gyuha/vertical-laptop-stand/.forge/followups.md

# Follow-ups

<!-- followup: fu-c87028a1e309 | source: printable-snap-retainer | task: 3 | date: 2026-10-28 | status: open | taken: - -->
- 소형 시험판을 X1C PLA로 출력한 뒤 새 클립의 삽입·분리, 갈라짐/흰 변형 자국, 축 방향 고정과 두 끝 회전 걸림을 확인하고 필요하면 여유·입구를 조정합니다.
  근거: 이번 계획은 실제 출력과 탄성·유지력 합격을 제외했으며, 실행 기록과 `docs/snap-retainer.md`의 실물 확인 양식은 미시험 상태입니다. 디지털 검사 통과와 구분한 후속 후보이고 자동 실행하지 않습니다.

<!-- followup: fu-9b2aa15bb850 | source: print-in-place-hinge | task: 4 | date: 2026-10-28 | status: open | taken: - -->
경첩 시험편(hinge-trial)을 X1C PLA·서포트 없이 출력해 출력 직후 풀림, 위 마디 원뿔 첫 링(302° 비지지)의 처짐·붙음, 흔들림을 확인하고 필요하면 radial_clearance·cone_normal_gap을 조정한다.
