gyuha/vertical-laptop-stand/docs/evidence/front-loaded.png

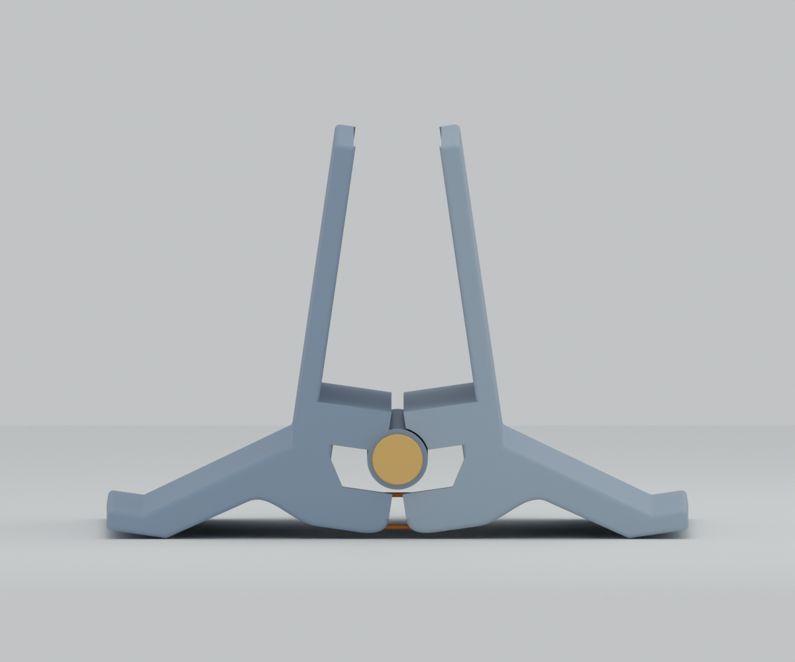
docs/evidence/front-loaded.png
