gyuha/vertical-laptop-stand/docs/evidence/front-open.png

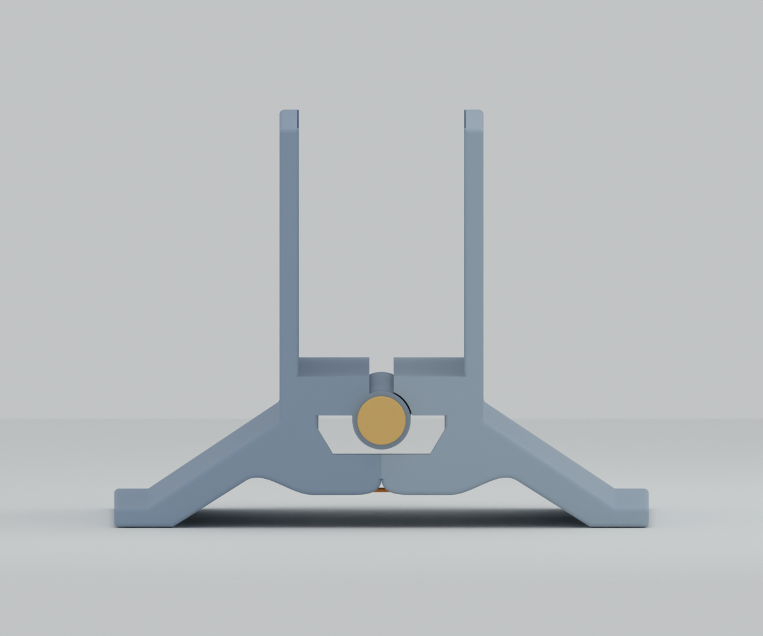
docs/evidence/front-open.png
