gyuha/vertical-laptop-stand/docs/evidence/hook-detail.png

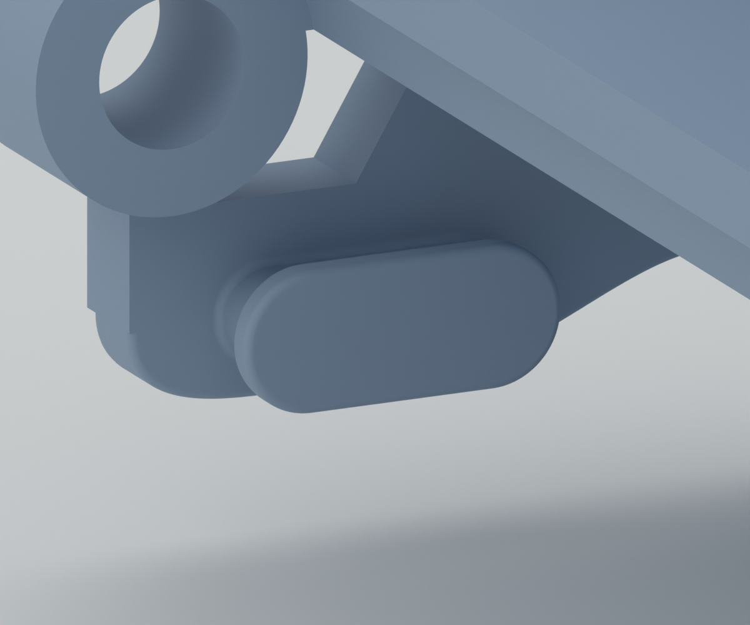
docs/evidence/hook-detail.png
