gyuha/vertical-laptop-stand/docs/evidence/hooks-preview.png

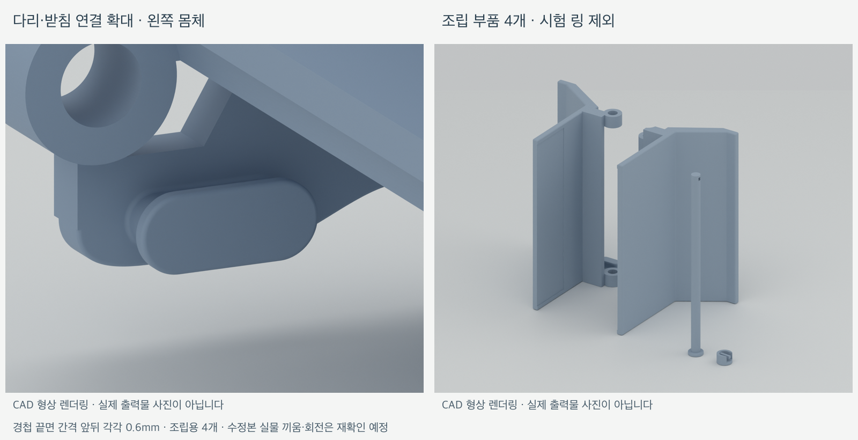
docs/evidence/hooks-preview.png
