gyuha/vertical-laptop-stand/docs/evidence/inside-loaded.png

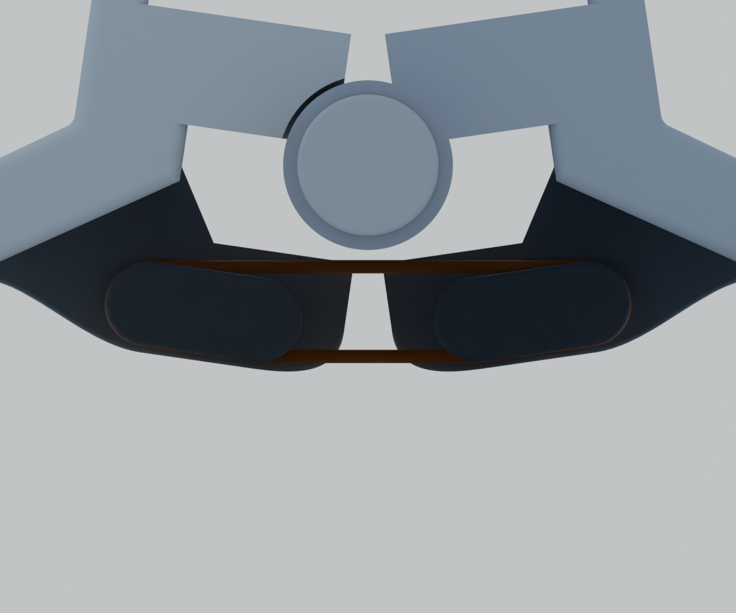
docs/evidence/inside-loaded.png
