gyuha/vertical-laptop-stand/docs/evidence/inside-open.png

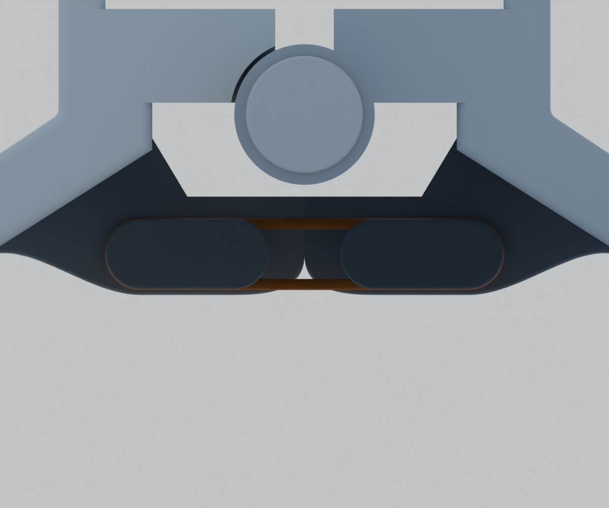
docs/evidence/inside-open.png
