gyuha/vertical-laptop-stand/docs/evidence/joint-detail-loaded.png

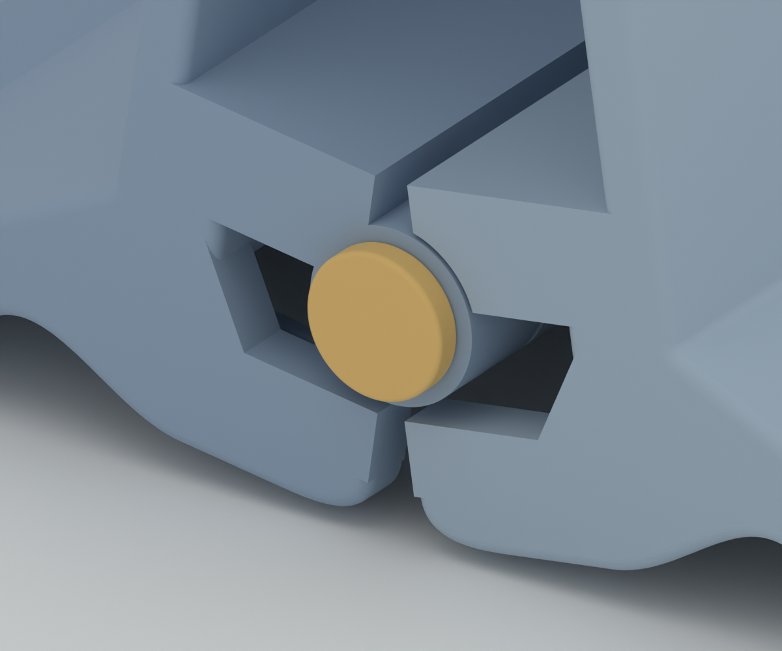
docs/evidence/joint-detail-loaded.png
