gyuha/vertical-laptop-stand/docs/evidence/joint-detail-open.png

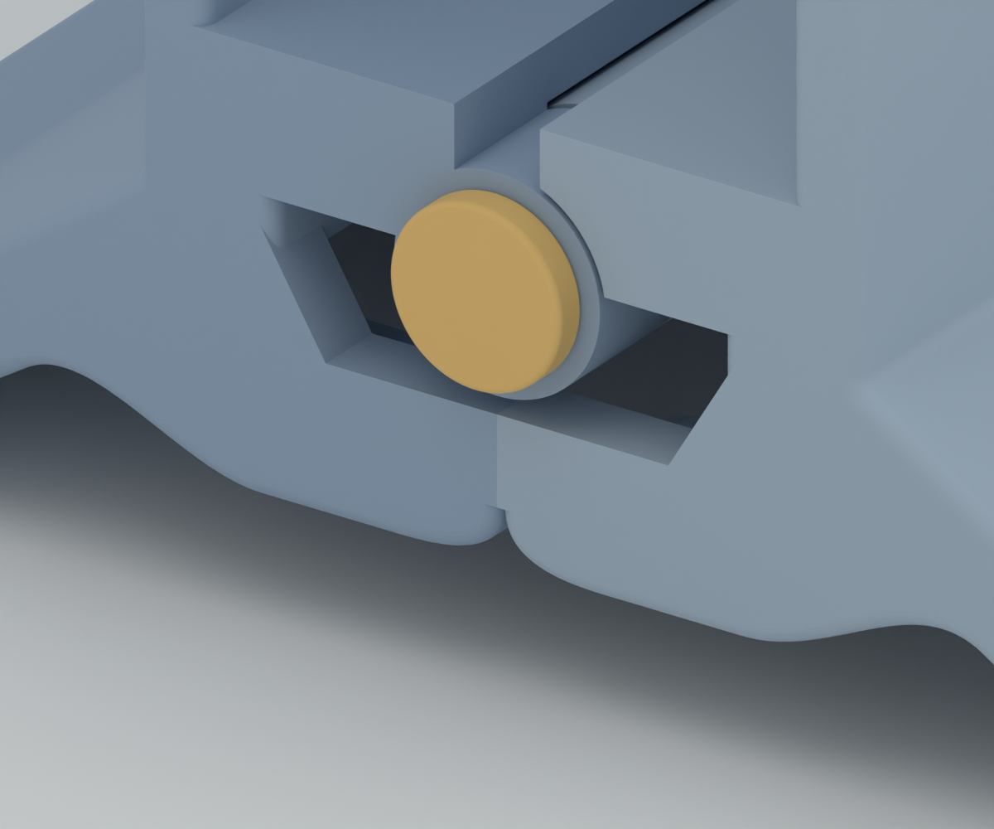
docs/evidence/joint-detail-open.png
