gyuha/vertical-laptop-stand/docs/evidence/key-detail.png

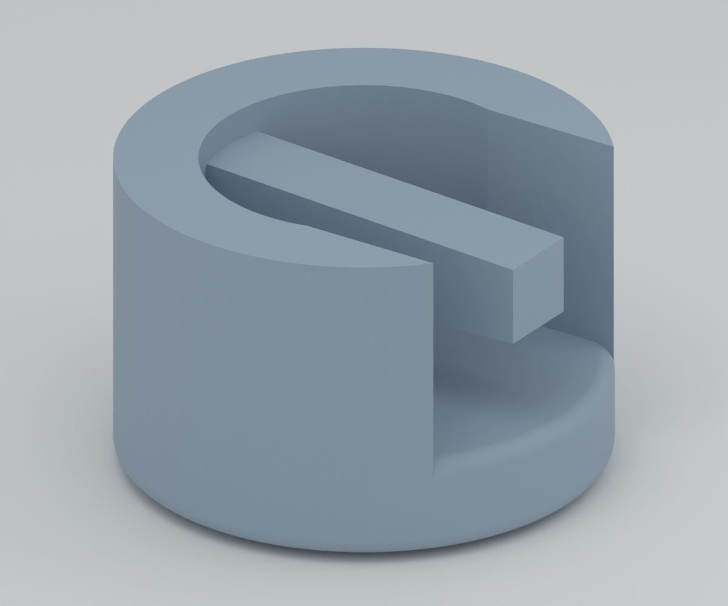
docs/evidence/key-detail.png
