gyuha/vertical-laptop-stand/docs/evidence/overview.png

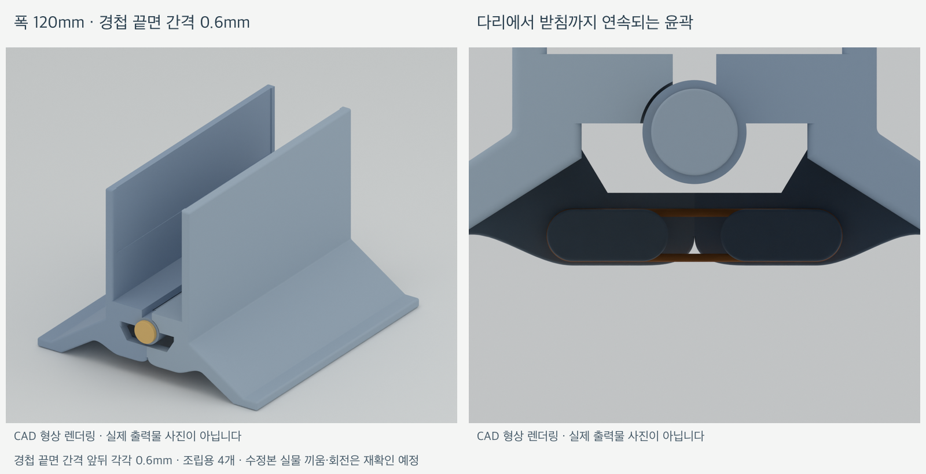
docs/evidence/overview.png
