gyuha/vertical-laptop-stand/docs/evidence/reference-body.png

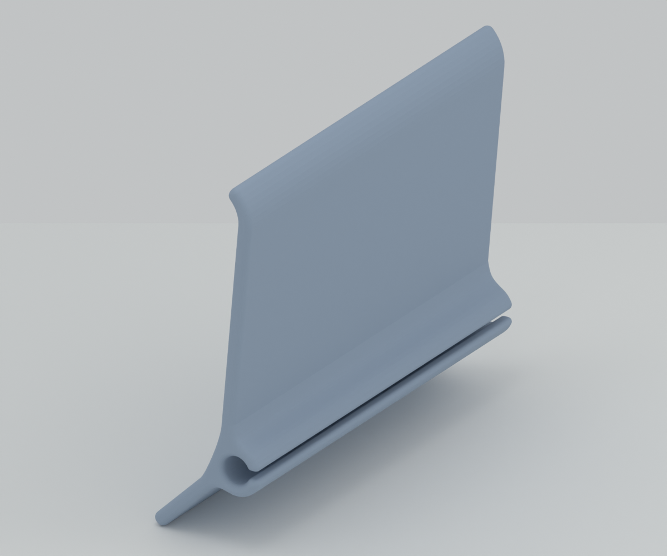
docs/evidence/reference-body.png
