gyuha/vertical-laptop-stand/docs/evidence/reference-connector.png

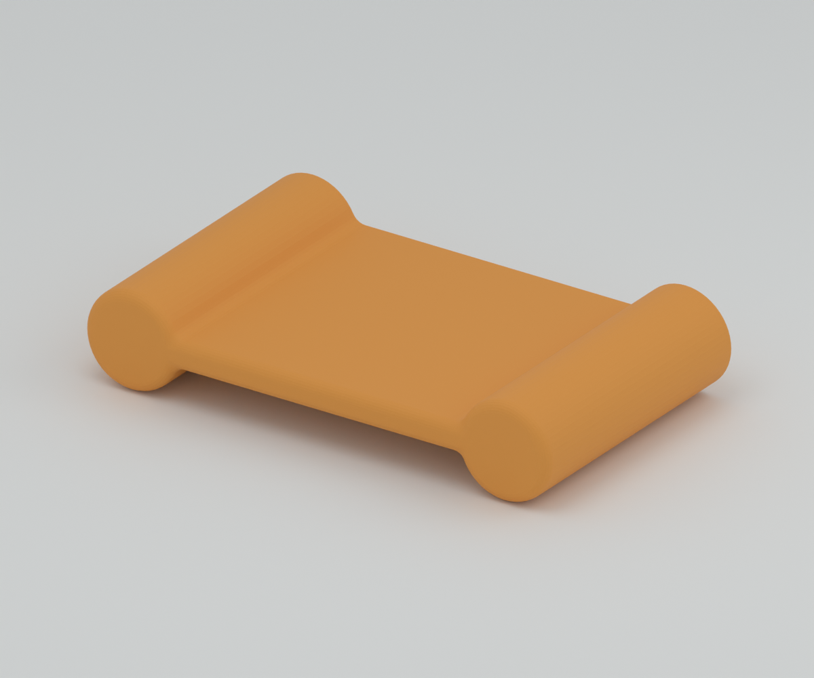
docs/evidence/reference-connector.png
