gyuha/vertical-laptop-stand/docs/evidence/retainer-preview.png

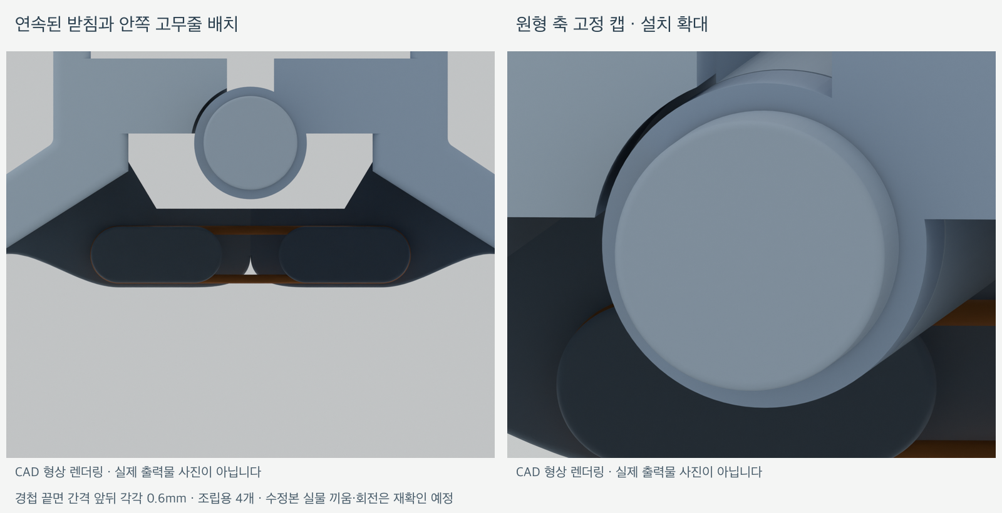
docs/evidence/retainer-preview.png
