gyuha/vertical-laptop-stand/docs/evidence/snap-retainer/clip-preview.png

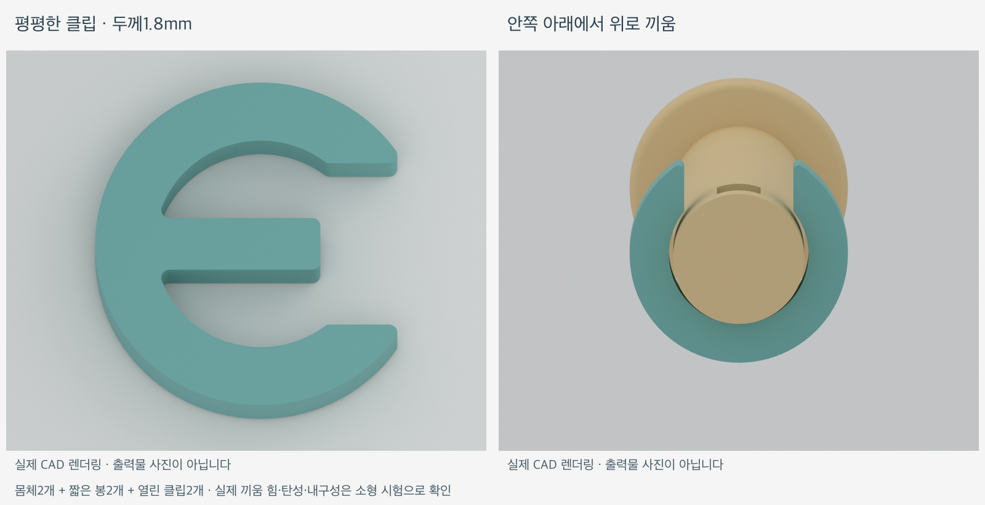
docs/evidence/snap-retainer/clip-preview.png
