gyuha/vertical-laptop-stand/docs/evidence/snap-retainer/fit-layout.png

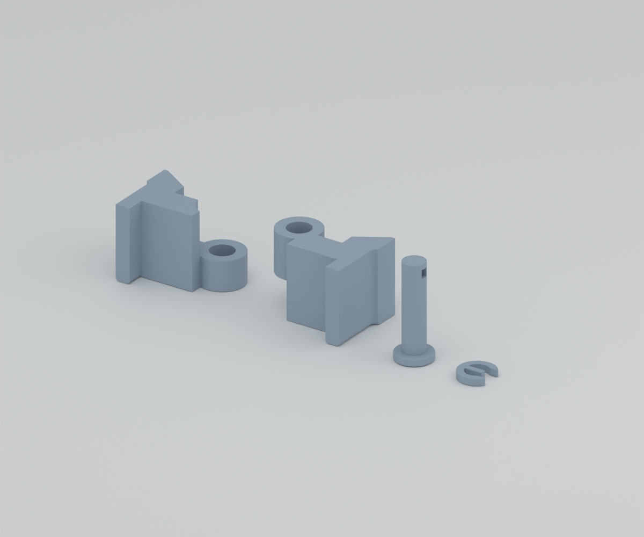
docs/evidence/snap-retainer/fit-layout.png
