gyuha/vertical-laptop-stand/docs/evidence/snap-retainer/overview.png

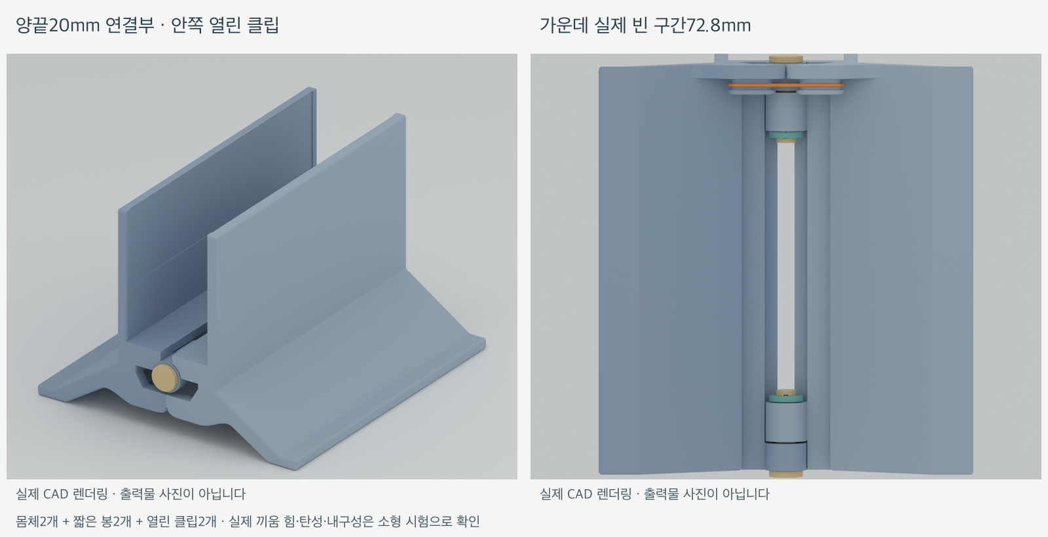
docs/evidence/snap-retainer/overview.png
