gyuha/vertical-laptop-stand/docs/evidence/snap-retainer/short-pin.png

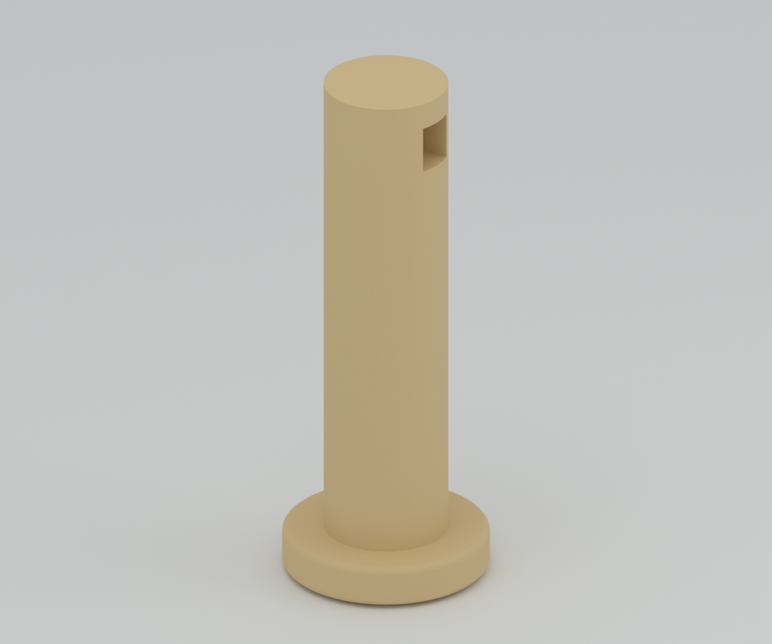
docs/evidence/snap-retainer/short-pin.png
