gyuha/vertical-laptop-stand/docs/evidence/snap-retainer/underside-loaded.png

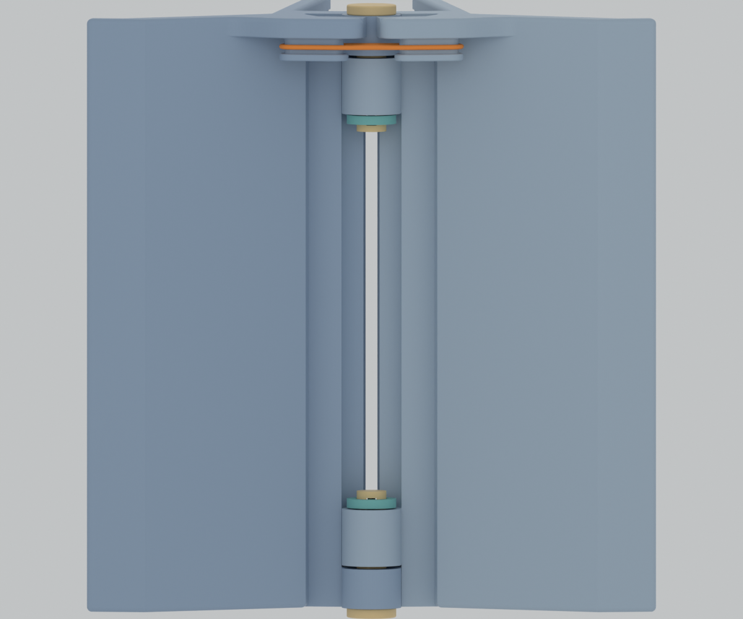
docs/evidence/snap-retainer/underside-loaded.png
