gyuha/vertical-laptop-stand/cad/snap-retainer-assembly.FCStd

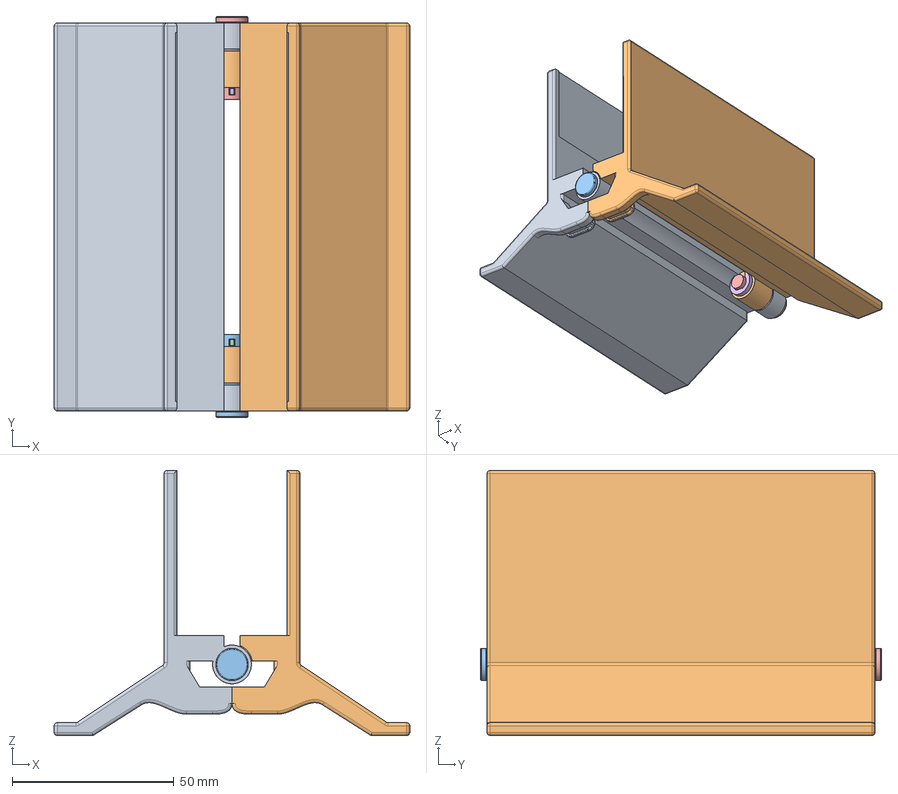
[picture p26: CAD file, 2026-10-28]
cad/snap-retainer-assembly.FCStd
110.0 x 124.0 x 82.0 mm
body-left
body-right
pin-front
clip-front
pin-rear
clip-rear
