gyuha/vertical-laptop-stand/docs/evidence/assembly-loaded-right.stl

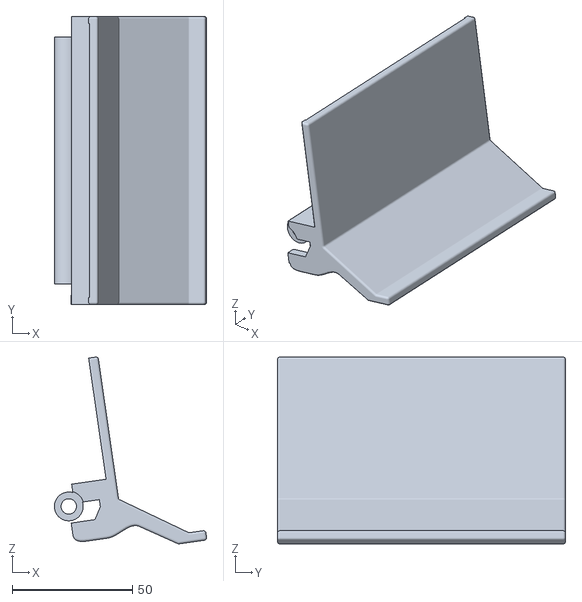
[picture p27: CAD file, 2026-10-27]
docs/evidence/assembly-loaded-right.stl
63.4 x 120.0 x 77.9
