gyuha/vertical-laptop-stand/exports/print-in-place/assembly-plate.step

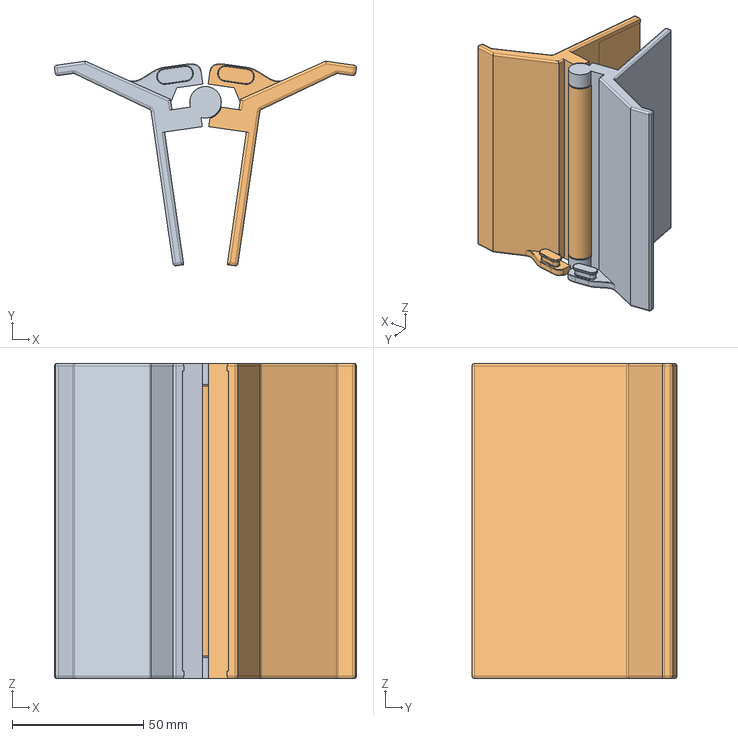
[picture p28: CAD file, 2026-10-28]
exports/print-in-place/assembly-plate.step
114.9 x 77.9 x 120.0 mm
