gyuha/vertical-laptop-stand/docs/evidence/assembly-loaded-left.stl

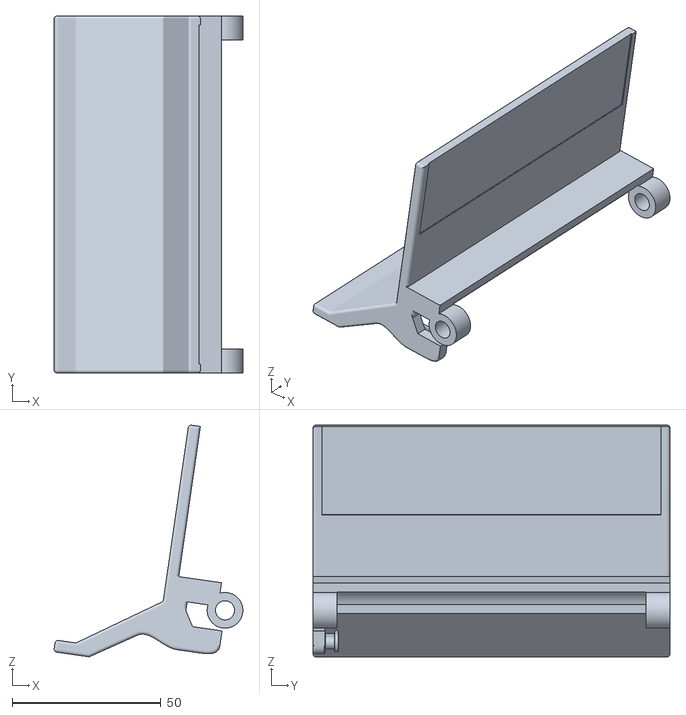
[picture p29: CAD file, 2026-10-27]
docs/evidence/assembly-loaded-left.stl
63.4 x 120.0 x 77.9
