gyuha/vertical-laptop-stand/exports/snap-retainer/assembly-plate.step

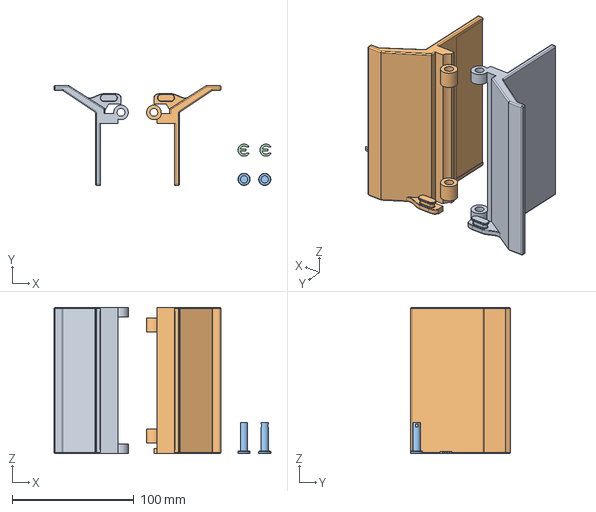
[picture p30: CAD file, 2026-10-28]
exports/snap-retainer/assembly-plate.step
178.1 x 82.0 x 120.0 mm
