gyuha/vertical-laptop-stand/cad/mechanism-assembly.FCStd

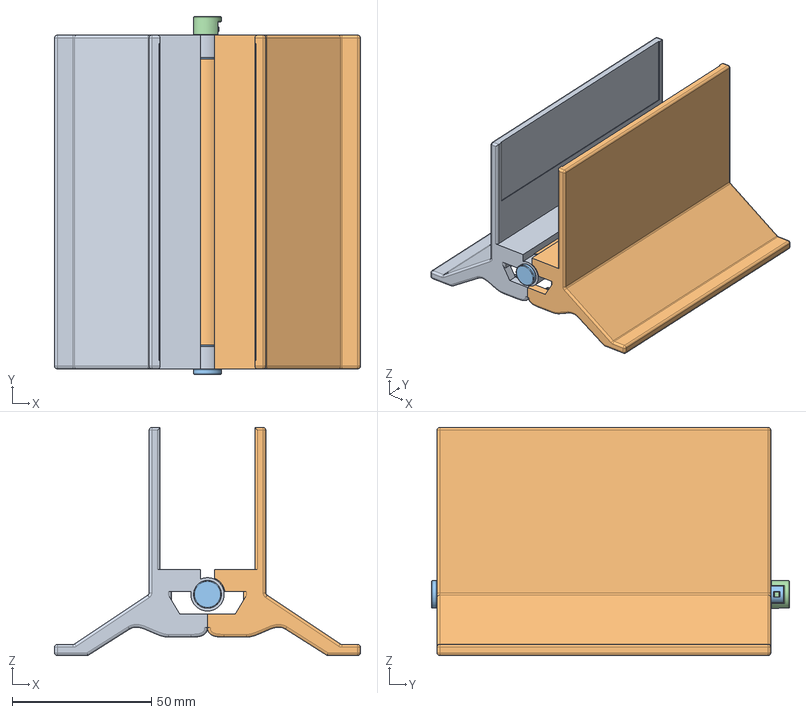
[picture p31: CAD file, 2026-10-27]
cad/mechanism-assembly.FCStd
110.0 x 128.7 x 82.0 mm
Left
Right
Axle
MainKey
