gyuha/vertical-laptop-stand/docs/evidence/assembly-open-left.stl

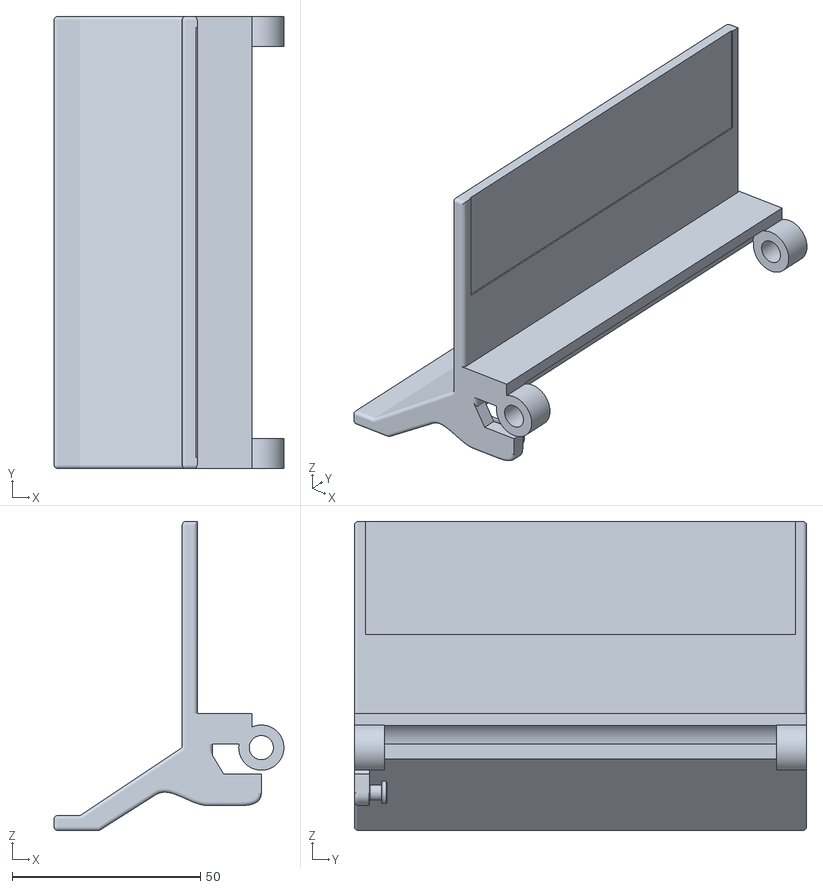
[picture p32: CAD file, 2026-10-27]
docs/evidence/assembly-open-left.stl
61.0 x 120.0 x 82.0
