gyuha/vertical-laptop-stand/docs/evidence/assembly-open-axle.stl

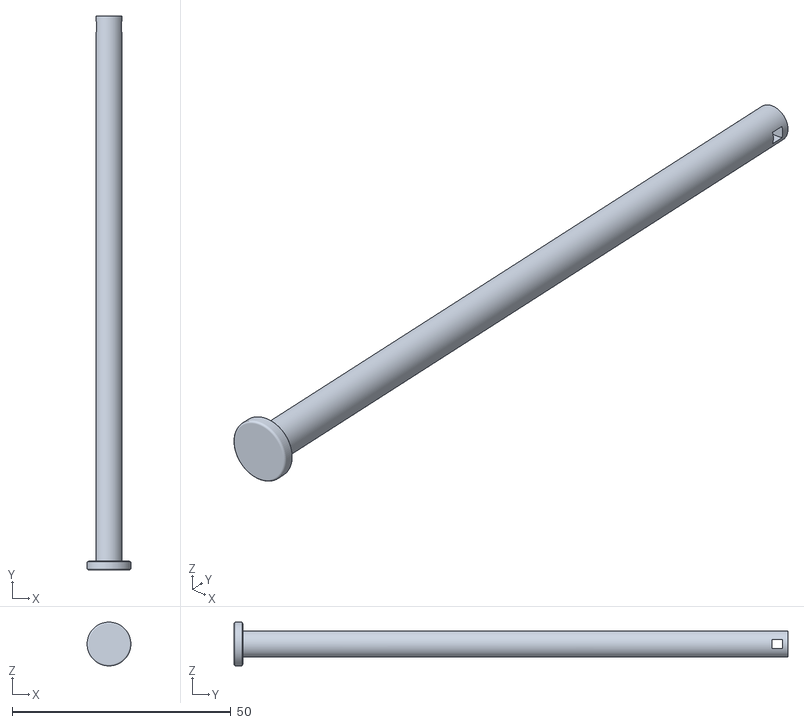
[picture p33: CAD file, 2026-10-27]
docs/evidence/assembly-open-axle.stl
10.00 x 126.5 x 10.00
