gyuha/vertical-laptop-stand/docs/evidence/assembly-open-main-key.stl

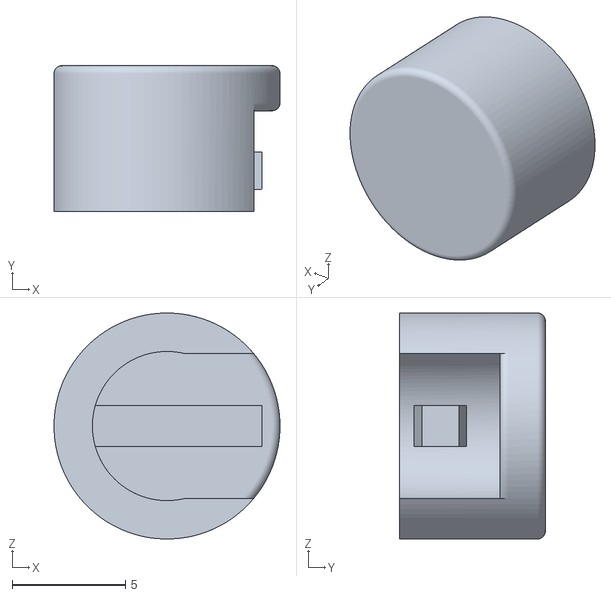
[picture p34: CAD file, 2026-10-27]
docs/evidence/assembly-open-main-key.stl
10.00 x 6.45 x 10.00
