gyuha/vertical-laptop-stand/docs/evidence/print-in-place/section-left.stl

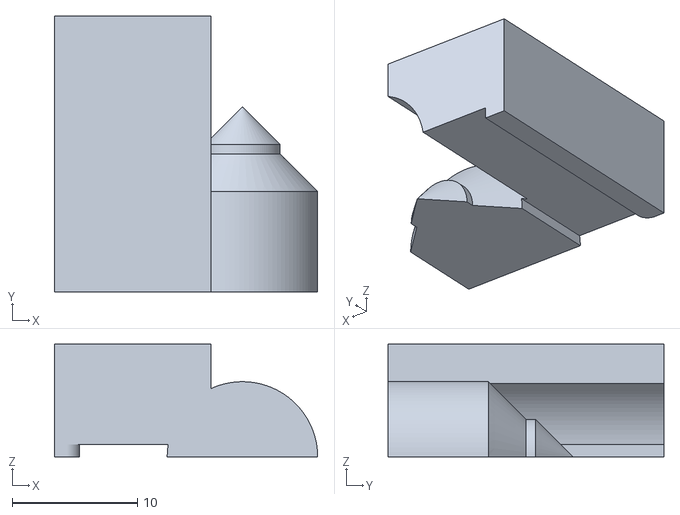
[picture p35: CAD file, 2026-10-28]
docs/evidence/print-in-place/section-left.stl
21.0 x 22.0 x 9.00
