gyuha/vertical-laptop-stand/exports/calibration/calibration-plate.stl

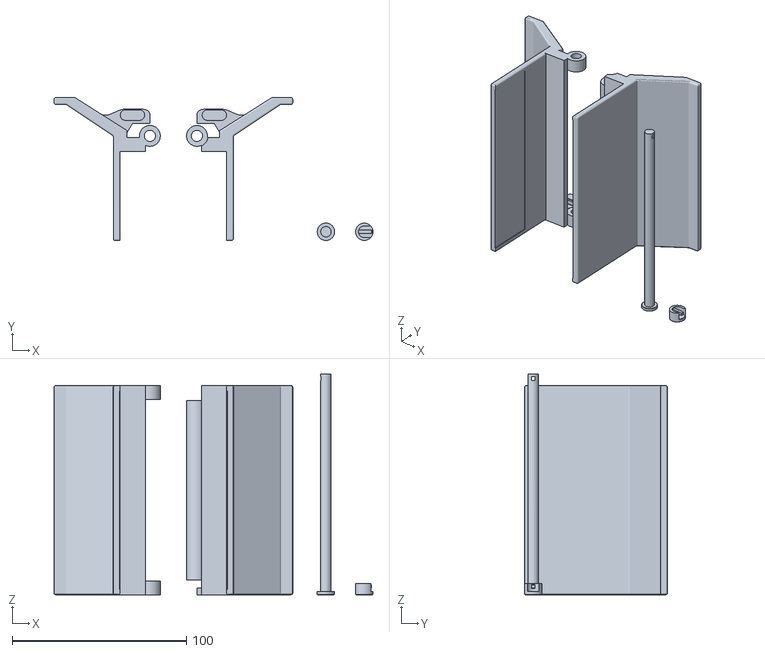
[picture p36: CAD file, 2026-10-27]
exports/calibration/calibration-plate.stl
183.0 x 82.0 x 126.5
