gyuha/vertical-laptop-stand/exports/calibration/sliced-fit/fit-x1c-pla.3mf

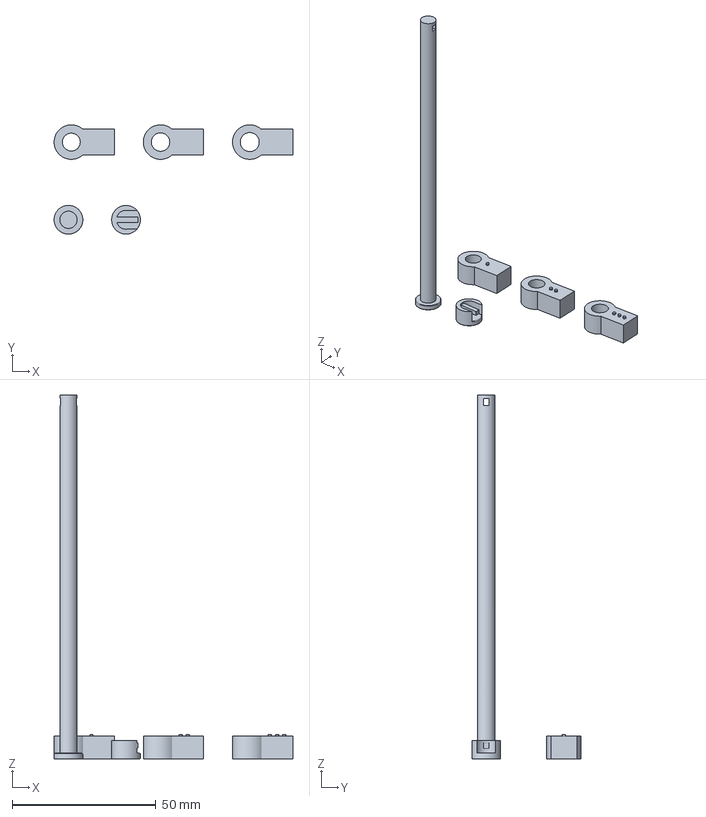
[picture p37: CAD file, 2026-10-27]
exports/calibration/sliced-fit/fit-x1c-pla.3mf
83.0 x 38.0 x 126.5 mm
