gyuha/vertical-laptop-stand/exports/print-in-place/hinge-trial.stl

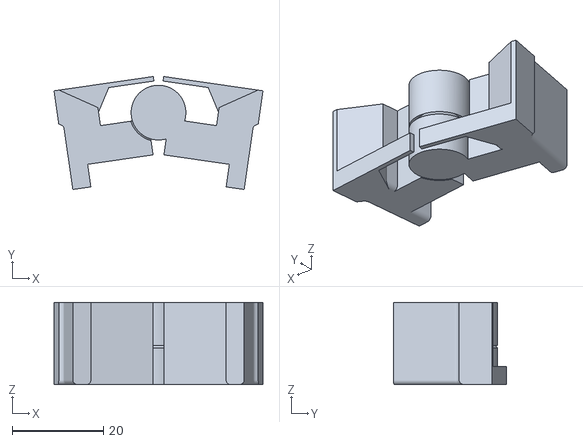
[picture p38: CAD file, 2026-10-28]
exports/print-in-place/hinge-trial.stl
45.8 x 24.8 x 18.0
