gyuha/vertical-laptop-stand/exports/snap-retainer/short-pin.stl

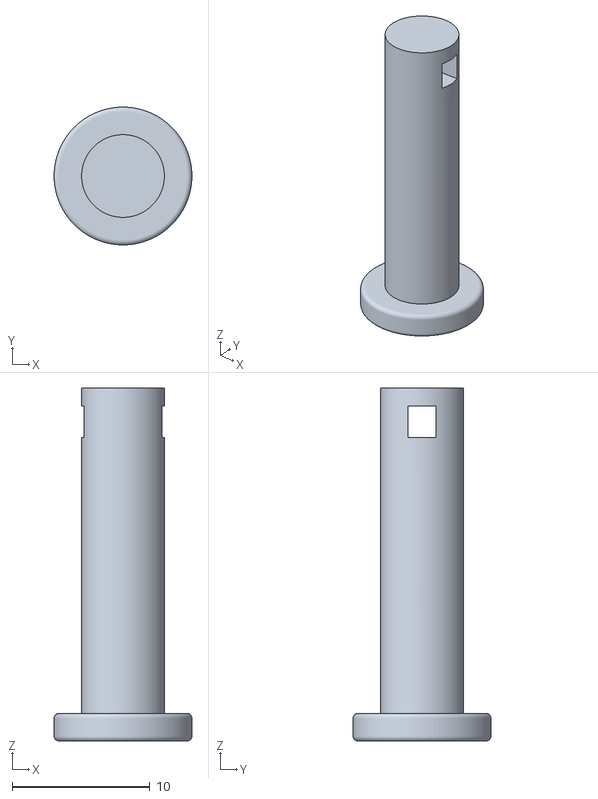
[picture p39: CAD file, 2026-10-28]
exports/snap-retainer/short-pin.stl
10.00 x 10.00 x 25.6
