gyuha/vertical-laptop-stand/exports/snap-retainer/sliced-fit/snap-fit-x1c-pla.3mf

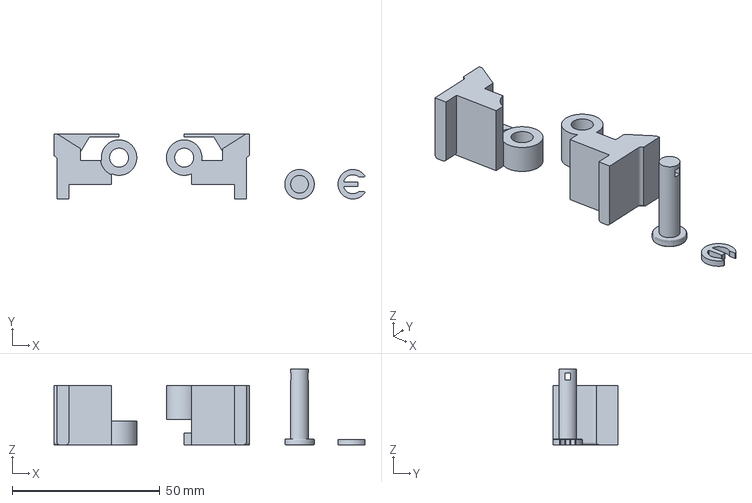
[picture p40: CAD file, 2026-10-28]
exports/snap-retainer/sliced-fit/snap-fit-x1c-pla.3mf
105.1 x 22.0 x 25.6 mm
