gyuha/vertical-laptop-stand/product.3mf

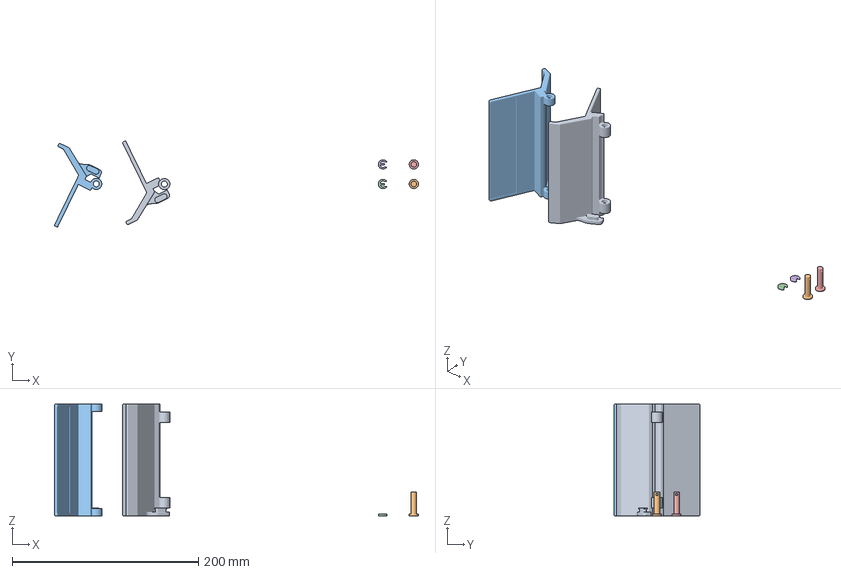
[picture p41: CAD file, 2026-10-28]
product.3mf
390.7 x 92.7 x 120.0 mm
body-right.stl
short-pin.stl x 2
body-left.stl
snap-clip.stl x 2
