gyuha/vertical-laptop-stand/references/connector-original.stl

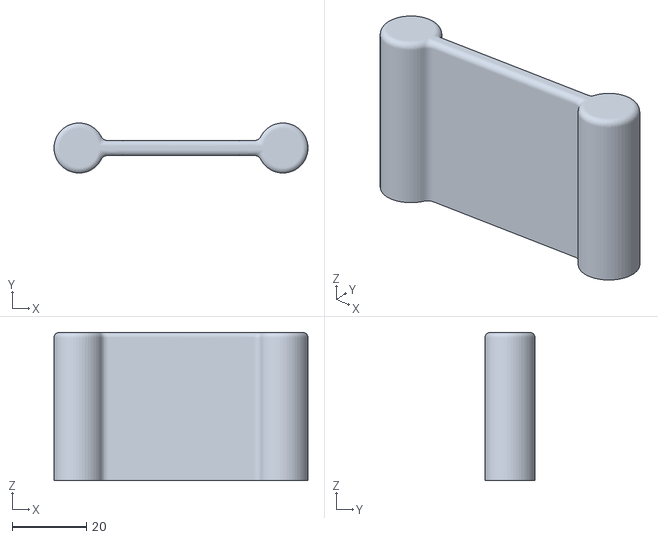
[picture p42: CAD file, 2026-10-27]
references/connector-original.stl
68.5 x 13.5 x 40.0
