gyuha/vertical-laptop-stand/docs/evidence/print-in-place/print-body-right.stl

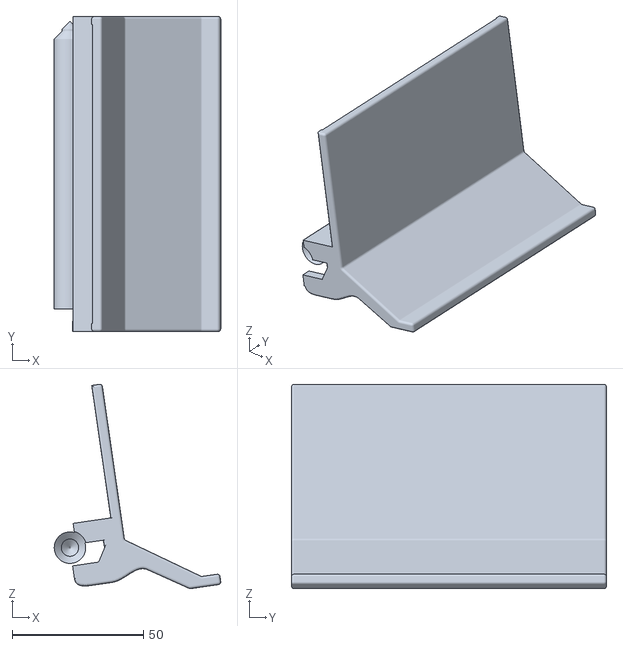
[picture p43: CAD file, 2026-10-28]
docs/evidence/print-in-place/print-body-right.stl
63.4 x 120.0 x 77.9
