gyuha/vertical-laptop-stand/references/body-original.stl

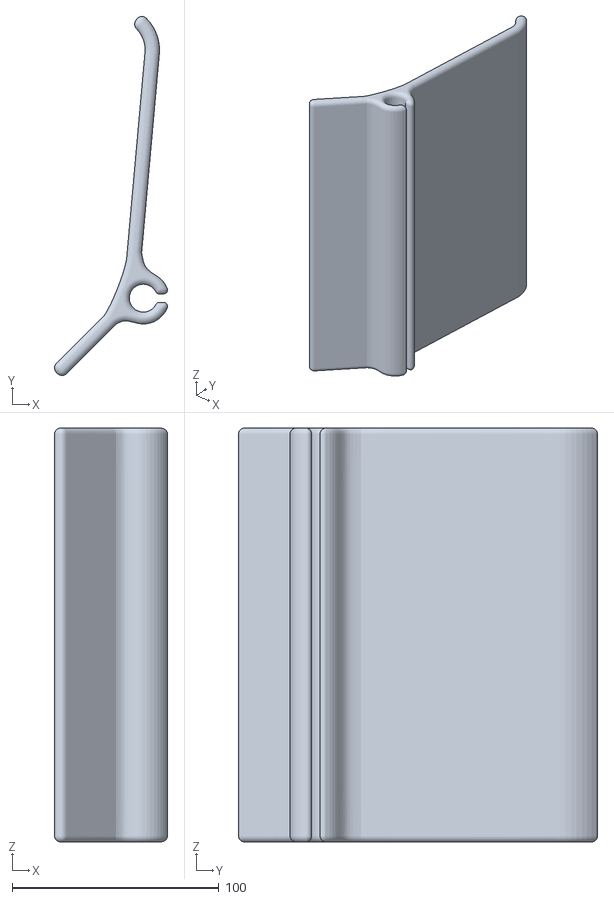
[picture p44: CAD file, 2026-10-27]
references/body-original.stl
54.6 x 173.5 x 200.0
