gyuha/vertical-laptop-stand/docs/evidence/print-in-place/open-body-right.stl

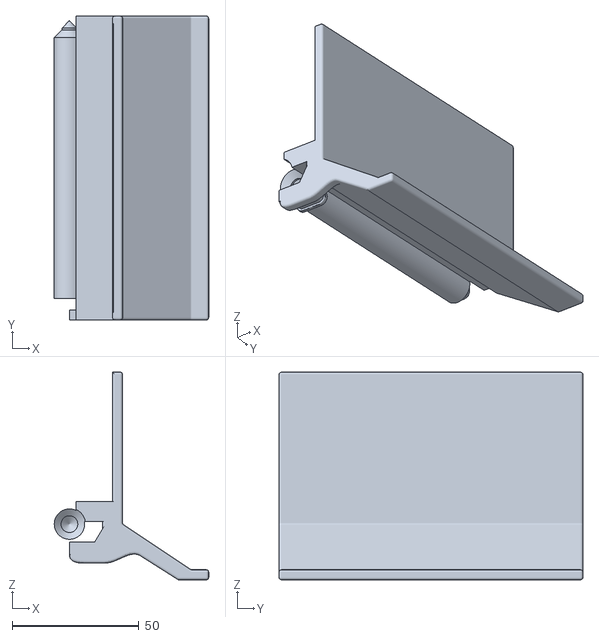
[picture p45: CAD file, 2026-10-28]
docs/evidence/print-in-place/open-body-right.stl
61.0 x 120.0 x 82.0
