gyuha/vertical-laptop-stand/docs/evidence/snap-retainer/open-clip-front.stl

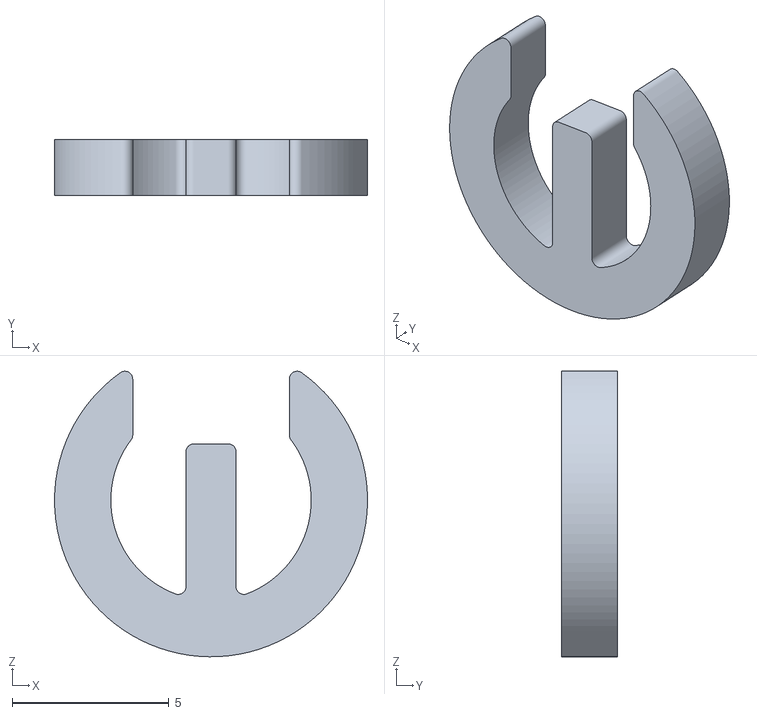
[picture p46: CAD file, 2026-10-28]
docs/evidence/snap-retainer/open-clip-front.stl
10.00 x 1.80 x 9.12
