gyuha/vertical-laptop-stand/exports/snap-retainer/trial-right.stl

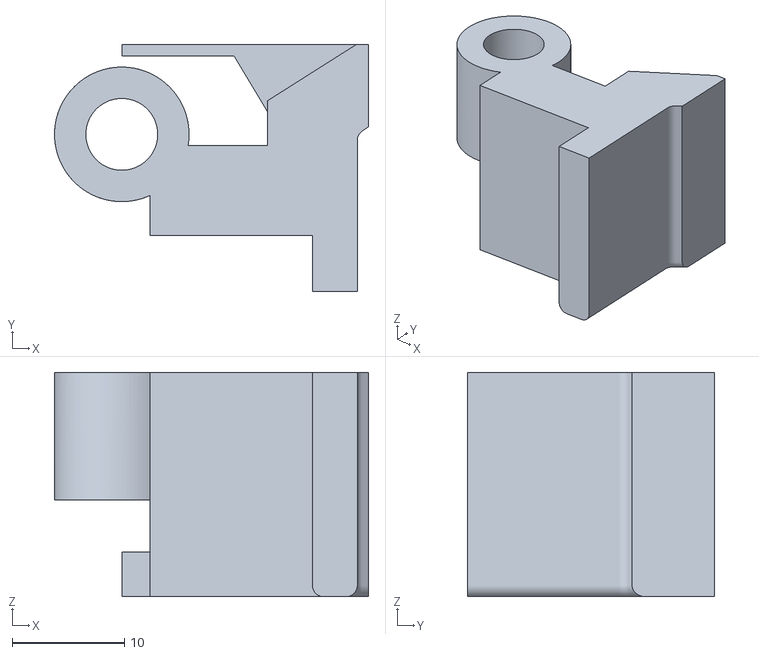
[picture p47: CAD file, 2026-10-28]
exports/snap-retainer/trial-right.stl
28.0 x 22.0 x 20.0
