gyuha/vertical-laptop-stand/exports/calibration/fit-20.stl

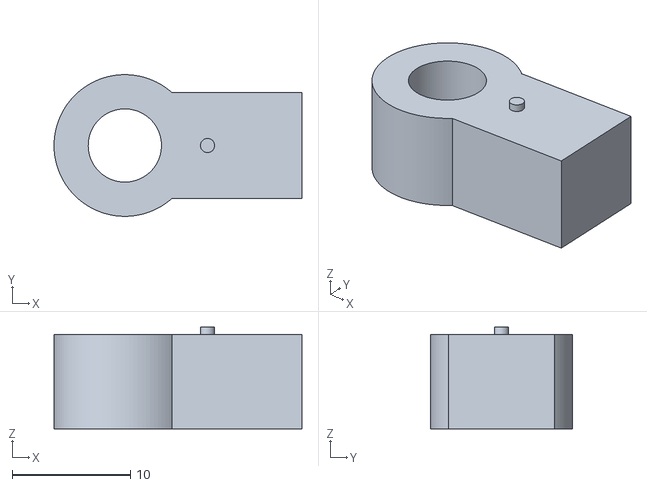
[picture p48: CAD file, 2026-10-27]
exports/calibration/fit-20.stl
21.0 x 12.0 x 8.60
