gyuha/vertical-laptop-stand/exports/snap-retainer/trial-left.stl

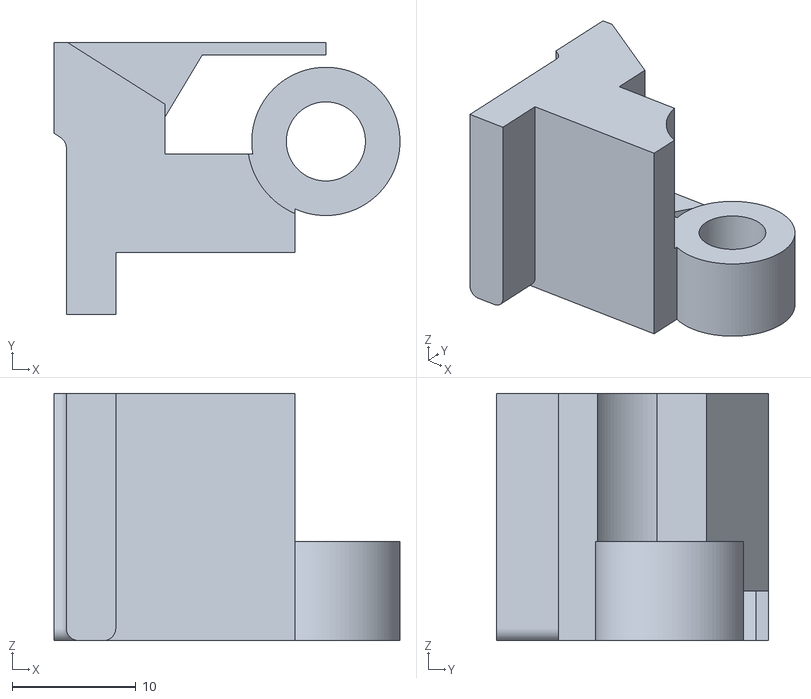
[picture p49: CAD file, 2026-10-28]
exports/snap-retainer/trial-left.stl
28.0 x 22.0 x 20.0
