gyuha/vertical-laptop-stand/(list of files, cad)

Other CAD files:
docs/evidence/assembly-loaded-main-key.stl
docs/evidence/assembly-loaded-axle.stl
cad/print-in-place.FCStd
docs/evidence/snap-retainer/open-body-left.stl
exports/calibration/sliced-mechanism/mechanism-x1c-pla.3mf
exports/print-in-place/sliced-assembly/print-in-place-x1c-pla.3mf
exports/print-in-place/sliced-trial/print-in-place-trial-x1c-pla.3mf
exports/snap-retainer/sliced-assembly/snap-retainer-x1c-pla.3mf
docs/evidence/snap-retainer/open-pin-rear.stl
exports/calibration/mechanism-right.stl
exports/snap-retainer/body-left.stl
cad/snap-retainer-print.FCStd
docs/evidence/print-in-place/section-right.stl
docs/evidence/snap-retainer/open-body-right.stl
exports/calibration/calibration.step
exports/calibration/mechanism-left.stl
cad/calibration.FCStd
docs/evidence/print-in-place/print-body-left.stl
docs/evidence/snap-retainer/loaded-pin-front.stl
exports/calibration/axle-key.stl
exports/snap-retainer/snap-fit-plate.stl
docs/evidence/print-in-place/open-body-left.stl
docs/evidence/snap-retainer/loaded-clip-front.stl
exports/calibration/fit-plate.stl
exports/snap-retainer/body-right.stl
docs/evidence/snap-retainer/loaded-clip-rear.stl
exports/calibration/axle-6mm.stl
exports/snap-retainer/snap-clip.stl
docs/evidence/snap-retainer/open-pin-front.stl
docs/evidence/snap-retainer/loaded-body-left.stl
exports/calibration/fit-40.stl
docs/evidence/snap-retainer/open-clip-rear.stl
exports/calibration/fit-60.stl
docs/evidence/snap-retainer/loaded-body-right.stl
docs/evidence/snap-retainer/loaded-pin-rear.stl
exports/print-in-place/assembly-plate.3mf
exports/print-in-place/assembly-plate.stl
exports/snap-retainer/assembly-plate.stl
