gyuha/vertical-laptop-stand/.forge/retro/261028-151500-print-in-place-hinge.md

# 2026-10-28 — v14 경첩을 조립 상태로 한 번에 출력하는 일체 출력 설계

## 계획과 실제

- 계획대로 진행한 점: v14 몸체를 재사용하고 반지름 6.35mm 안쪽만 회전체로 다시 만들었다. 일체형 ø6 축과 ø6.6 구멍, 45° 원뿔 끝면(수직 틈 0.4), 8.2° 출력 자세, 서포트 없는 슬라이싱, 시험편과 전체 판, 문서와 ZIP을 모두 제공했다. 근거는 `.forge/run.md`의 S1·S3·S4와 `docs/evidence/print-in-place/geometry-report.json`이다.
- 조정한 점: DoD 3의 "45° 초과 아랫면 0"을 STL 면 법선으로 판정하자, 정확한 45° 원뿔도 이음선의 근사 조각 때문에 실패했다(최대 약 2.1°). 메시를 촘촘히 해도(21MB) 남아서, 정확한 판정은 CAD 면 법선 표본으로 바꾸고 메시는 42° 허용으로 남겼다(`scripts/check_print_in_place.py`).
- 조정한 점: 뒤쪽 왼쪽 마디가 8mm뿐이라 축의 원통 맞물림은 약 0.77mm에 그치고 나머지는 원뿔 끝이 담당한다.
- 측정된 위험: 위 마디 원뿔의 첫 링은 원둘레 302°에서 아래에 받침이 없다(`upper_rim_unsupported_arc_deg`). 면 기울기 검사가 통과해도 남는 위험이며, 실물 시험편으로만 확인할 수 있다.

## 배운 점

- 다음에는 축을 세워 출력하는 회전 대칭 경첩을 grilling(계획을 질문으로 검증하는 단계)할 때 원뿔 각도만 묻지 않는다. 위 마디가 자기 몸체와 몇 도만큼 연결되는지, 즉 첫 층이 허공에서 시작하는 범위부터 측정하고 질문한다. 이번에는 실행 중에야 302° 비지지가 드러났다.
- 다음에는 "N° 초과 면적 0" 같은 출력성 완료 조건을 STL 법선으로만 정의하지 않는다. 정확한 판정은 CAD 면으로 하고, 메시는 근사 허용을 명시한다. 그리고 면 기울기 검사가 잡지 못하는 "지지 연속성"은 별도 수치로 정의한다.
- 다음에는 공용 스크립트(`slice_calibration.py`)를 수정한 뒤 기존 대상을 재실행해 회귀 확인을 할 때, 추적 중인 결과 파일이 처리 시간 값만으로도 바뀐다는 점을 감안한다. 확인 후 되돌리거나, 시간 필드를 비교에서 제외한다.
- 유지할 점: 직렬 의존 작업은 워크플로 없이 직접 실행했고, 기존 산출물이 git 변경 없이 보존되는지 매번 확인했다.

## 문서 갱신

- CONTEXT.md 승격: 없음. 다만 이번 작업에서 grilling 중 "일체 출력 경첩" 용어를 추가했다.
- ADR 추가: 없음. 별도 변형 설계이고 기존 설계를 보존하므로 되돌리기 어려운 결정이 아니다.
- 검사(eval) 승격: 없음. 회귀 검사는 이미 `--target print-in-place`로 구현되어 있다.

## 후속 후보

<!-- followup: fu-9b2aa15bb850 | source: print-in-place-hinge | task: 4 | date: 2026-10-28 | status: open | taken: - -->
- 경첩 시험편(hinge-trial)을 X1C PLA·서포트 없이 출력해 출력 직후 풀림, 위 마디 원뿔 첫 링(302° 비지지)의 처짐·붙음, 흔들림을 확인하고 필요하면 radial_clearance·cone_normal_gap을 조정한다.
  근거: 검사 보고서의 `upper_rim_unsupported_arc_deg` 302°와 실물 미시험 상태.
