gyuha/vertical-laptop-stand/.forge/retro/261028-135821-printable-snap-retainer.md

# 2026-10-28 — 양끝 분리 경첩과 안쪽 열린 클립 설계

## 계획과 실제

- 계획대로 진행한 점: 양끝20mm 연결부·기존 형태의 짧은 봉2개·안쪽 열린 클립2개·기본6개 모음과 별도4개 소형 시험판을 제공했습니다. 실제 중앙 빈 구간72.8mm, 새8STL 및33개 회전 자세, 두 판 슬라이싱의 통과 기록은 `.forge/run.md`의 S1~S5 및 `docs/evidence/snap-retainer/geometry-report.json`·두 `sliced-*/result.json`에 있습니다.
- 조정한 점: 옆으로 넣는 초기 클립은 몸체 목과 충돌했습니다. 봉의 슬롯 모양은 유지하고 조립 방향을90도 돌려 아래에서 위로 넣도록 바꿨습니다. 원통으로 잘라 목이 분리된 시험편은 목까지 포함하는 범위로 수정했습니다. 근거는 실행 기록의 ‘계획 대비 조정과 검토 반영’ 및 `end_pose()`·`trial_half()`입니다.
- 조정한 점: 클립 혀 높이를1.6mm로 줄이고, 입구는 실제 단면으로 측정하며 STL/CAD 체적·경계와 개별 형상의 차집합을 대조하도록 검사했습니다. 최종 슬라이싱 보조 검사의 호출 순서를 바로잡은 뒤 두 실제 명령을 다시 실행했습니다. 근거는 실행 기록과 `scripts/check_snap_retainer.py`·`scripts/slice_calibration.py`입니다.

## 배운 점

- 다음에는 조립 완료 위치와 함께 실제 접근 경로부터 확인합니다. 이번 옆 방향 접근은 끝 위치만으로는 드러나지 않는 목 간섭이 있었고, 아래 방향41개 위치 검사로 수정 결과를 확인했습니다. 근거는 실행 기록의 첫 조정 항목과 형상 보고서 `insertion_paths`입니다.
- 다음에는 끼움 시험편의 구멍뿐 아니라 연결 목도 남기는 범위로 잘라 단일 솔리드인지 확인합니다. 이번 원통 절단의 분리 문제와 수정은 실행 기록에 남겼습니다.
- 유지할 점: 사용자 선택대로 형상을 만든 후 실제 산출물과 슬라이싱을 검사하고, 의도한 양팔 탄성 접촉을 우발적 충돌과 구분했습니다. 한 팔당0.5mm의 기하학적 벌림을 실제 힘·탄성·강도 합격으로 취급하지 않았습니다. 근거는 형상 보고서의 `elasticity_assessment`와 실행 기록의 검증 범위입니다.
- 분류: 조립 경로·시험편 절단·재생성 순서는 이번 구현/검증 과정의 교훈으로 이 회고에 보존합니다. 관련 회귀 검사는 이미 새 검사기에 구현됐으며 추가 검사 승격은 없습니다. 새로운 도메인 용어와 되돌리기 어려운 결정은 없습니다.

## 문서 갱신

- CONTEXT.md 승격: 추가 없음. 작업 중 반영한 양끝 분리 연결부·단축 출력 봉·안쪽 열린 클립·6개 조립 모음의 정의는 기존 `.forge/CONTEXT.md`에 있습니다.
- ADR 추가: 없음.
- 추가 회귀 검사 승격: 없음. 이번 실행에서 구현하고 통과한 검사기를 유지합니다.

## 후속 후보

<!-- followup: fu-c87028a1e309 | source: printable-snap-retainer | task: 3 | date: 2026-10-28 | status: open | taken: - -->
- 소형 시험판을 X1C PLA로 출력한 뒤 새 클립의 삽입·분리, 갈라짐/흰 변형 자국, 축 방향 고정과 두 끝 회전 걸림을 확인하고 필요하면 여유·입구를 조정합니다.
  근거: 이번 계획은 실제 출력과 탄성·유지력 합격을 제외했으며, 실행 기록과 `docs/snap-retainer.md`의 실물 확인 양식은 미시험 상태입니다. 디지털 검사 통과와 구분한 후속 후보이고 자동 실행하지 않습니다.
