gyuha/vertical-laptop-stand/docs/evidence/assembly-loaded.png

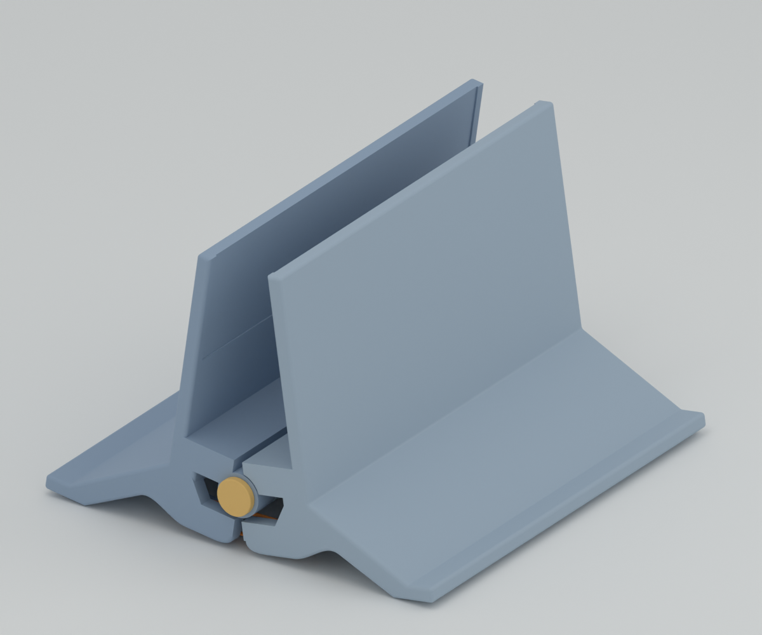
docs/evidence/assembly-loaded.png
