gyuha/vertical-laptop-stand/docs/evidence/assembly-open.png

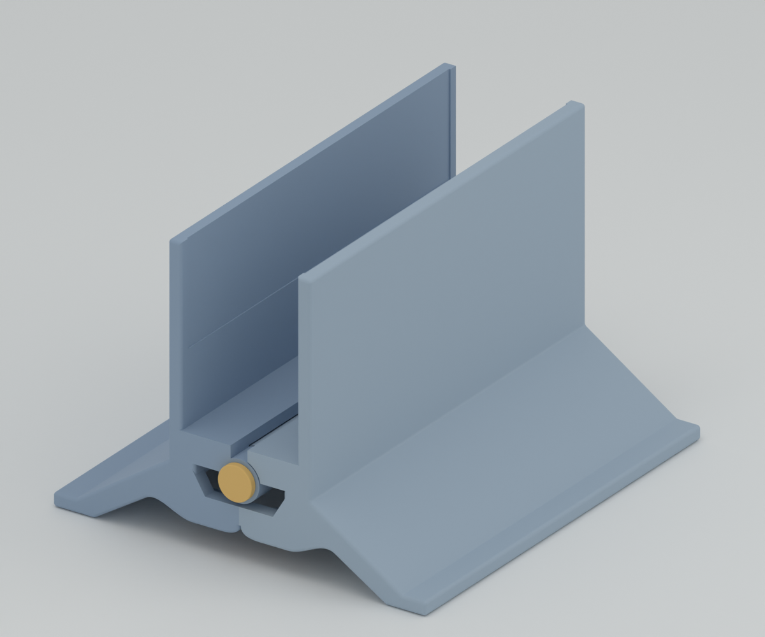
docs/evidence/assembly-open.png
