gyuha/vertical-laptop-stand/docs/evidence/print-in-place/assembly-print.png

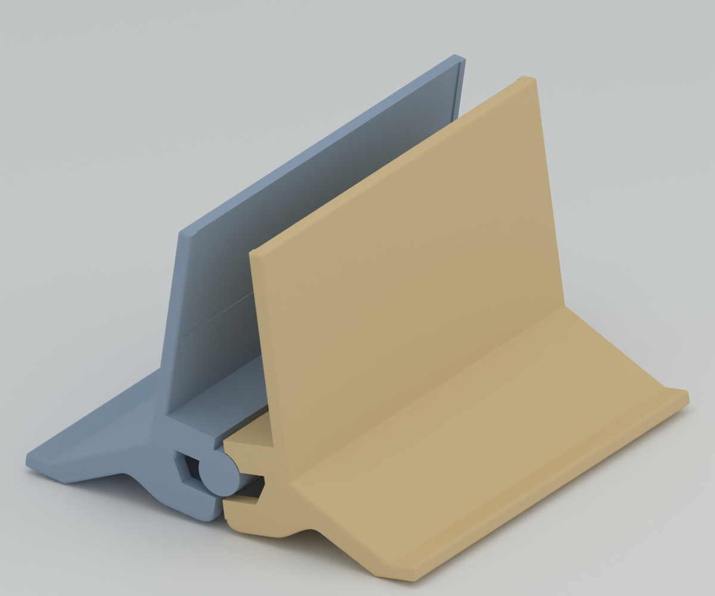
docs/evidence/print-in-place/assembly-print.png
