gyuha/vertical-laptop-stand/docs/evidence/print-in-place/trial-layout.png

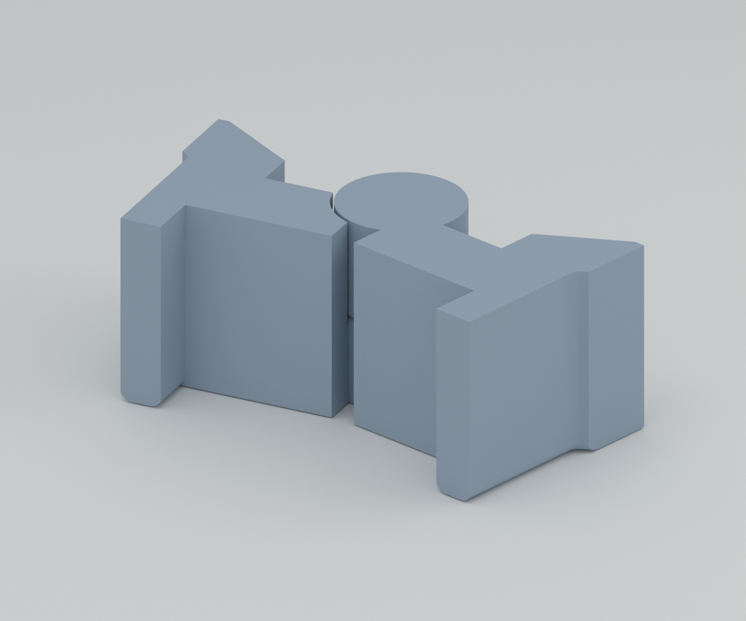
docs/evidence/print-in-place/trial-layout.png
