gyuha/vertical-laptop-stand/docs/evidence/print-layout.png

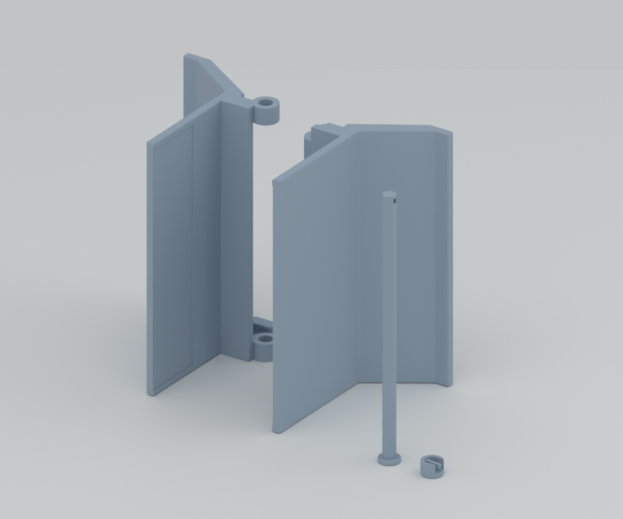
docs/evidence/print-layout.png
