gyuha/vertical-laptop-stand/docs/evidence/retainer-installed.png

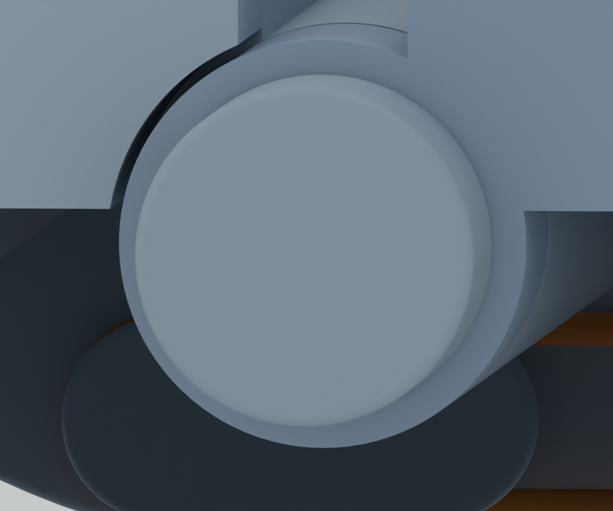
docs/evidence/retainer-installed.png
