gyuha/vertical-laptop-stand/docs/evidence/snap-retainer/assembly-loaded.png

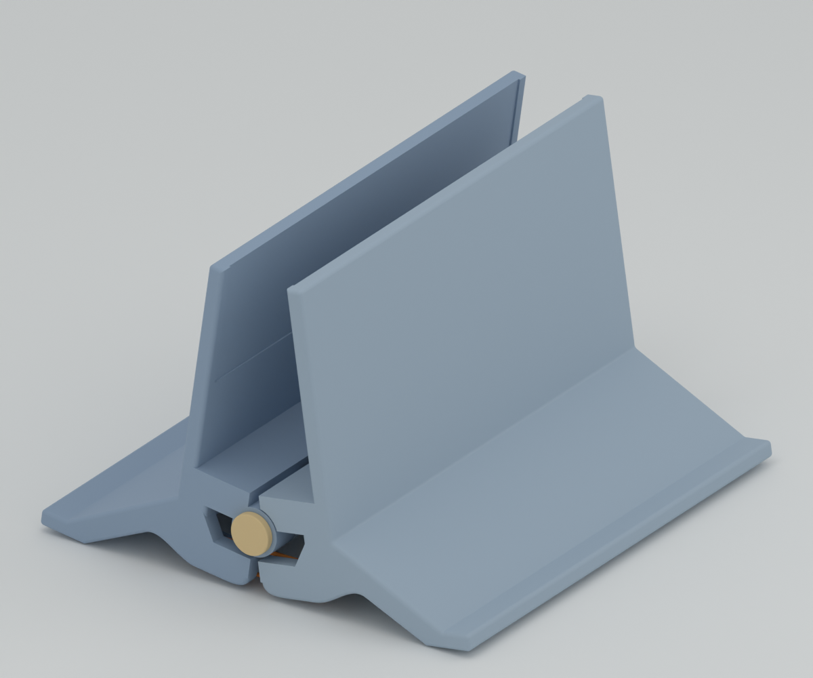
docs/evidence/snap-retainer/assembly-loaded.png
