gyuha/vertical-laptop-stand/docs/evidence/snap-retainer/print-layout.png

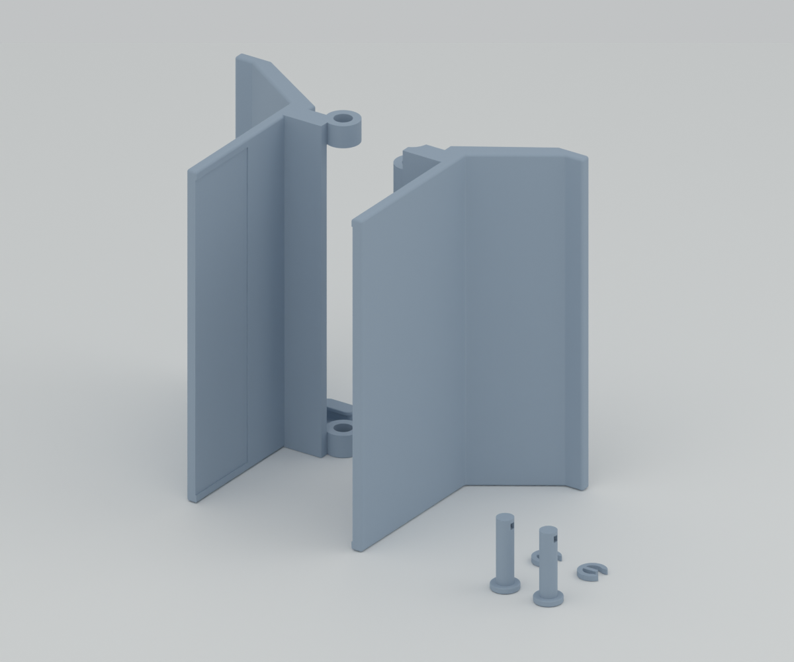
docs/evidence/snap-retainer/print-layout.png
