gyuha/vertical-laptop-stand/(commit log)

2026-10-27 Add weight-actuated laptop stand prototype and documentation
    [assembly-loaded-axle.stl, assembly-loaded-left.stl, assembly-loaded-main-key.stl, assembly-loaded-right.stl, assembly-open-axle.stl, assembly-open-left.stl, assembly-open-main-key.stl, assembly-open-right.stl]
2026-10-27 Widen band hooks to capsules and increase hinge end-face gap
    [assembly-loaded-left.stl, assembly-loaded-right.stl, assembly-open-left.stl, assembly-open-right.stl, calibration-plate.stl, calibration.FCStd, calibration.step, mechanism-assembly.FCStd]
2026-10-27 Reduce hinge end-face gap to 0.6mm and regenerate exports
    [assembly-loaded-right.stl, assembly-open-right.stl, calibration-plate.stl, calibration.FCStd, calibration.step, mechanism-assembly.FCStd, mechanism-right.stl, mechanism-x1c-pla.3mf]
2026-10-28 Add dual-end snap retainer design with short pins and clips
    [assembly-plate.step, assembly-plate.stl, body-left.stl, body-right.stl, loaded-body-left.stl, loaded-body-right.stl, loaded-clip-front.stl, loaded-clip-rear.stl]
2026-10-28 Add print-in-place hinge design printed assembled without axle
    Rebuild the v14 hinge core as integral cone-tipped pins with 45-degree
    cone end faces (0.3mm radial, 0.4mm normal gap) so both bodies print
    interlocked at 8.2 degrees with supports off. Adds generator, checker
    target, support-free slicing kits, renders, guide, and kit ZIP; legacy
    v14 and snap-retainer outputs are unchanged.
    [assembly-plate.3mf, assembly-plate.step, assembly-plate.stl, hinge-trial.stl, machine.json, open-body-left.stl, open-body-right.stl, print-body-left.stl]
2026-10-28 Update README for print-in-place model and fix band hooking step
    README now presents the print-in-place hinge as the current model, with
    trial-first printing, support-off settings, known first-layer risk, and
    links to the snap-retainer and v14 models. The guide no longer says to
    hook the band before joining the halves, which is impossible when they
    print interlocked. Kit ZIP rebuilt for the changed guide.
